mhzkb/submission/README.md

# Submission

submission
