mhzkb/submission/case/bottom-mount-case.FCStd

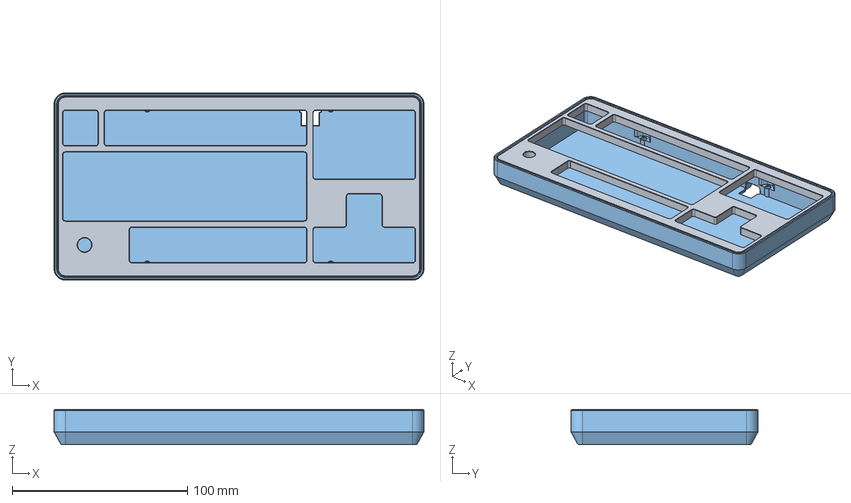
[picture p1: CAD file, 2025-06-23]
case/bottom-mount-case.FCStd
211.1 x 106.8 x 20.0 mm
top_case
SUBM
