mhzkb/submission/pcb/export/submission.step

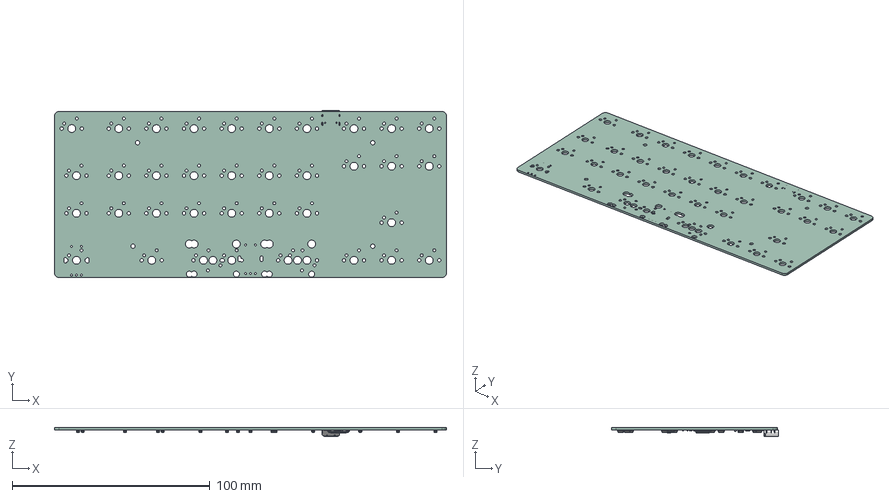
[picture p2: CAD file, 2025-10-24]
pcb/export/submission.step
198.4 x 84.6 x 4.45 mm
D_SOD_123 x 36
C_0402_1005Metric x 9
LQFP_48_7x7mm_P05mm
SW_SPST_TL3342 x 2
SOT_143
SOT_23
R_0402_1005Metric x 4
Fuse_1206_3216Metric
CON_TYPE-C-31-M-12 v0
C_0603_1608Metric
submission_PCB
