mhzkb/submission/plate/export/submission-plate.step

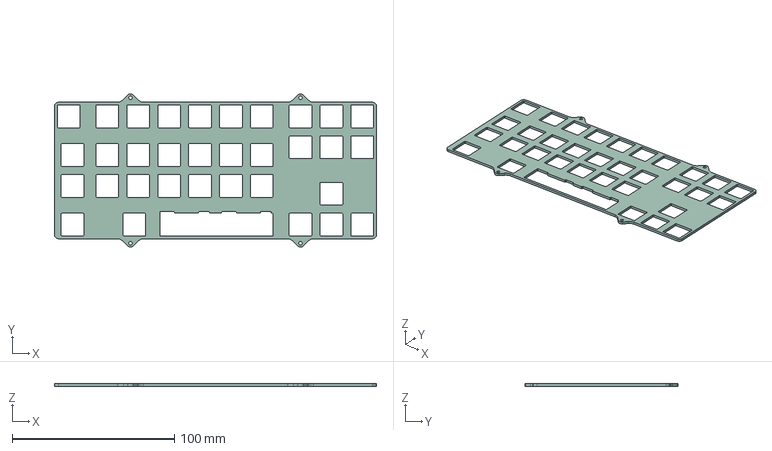
[picture p3: CAD file, 2026-05-04]
plate/export/submission-plate.step
198.4 x 94.5 x 1.60 mm
