mhzkb/submission/pcb/submission.kicad_pcb

## KiCad design pcb/submission.kicad_pcb (2026-05-04)

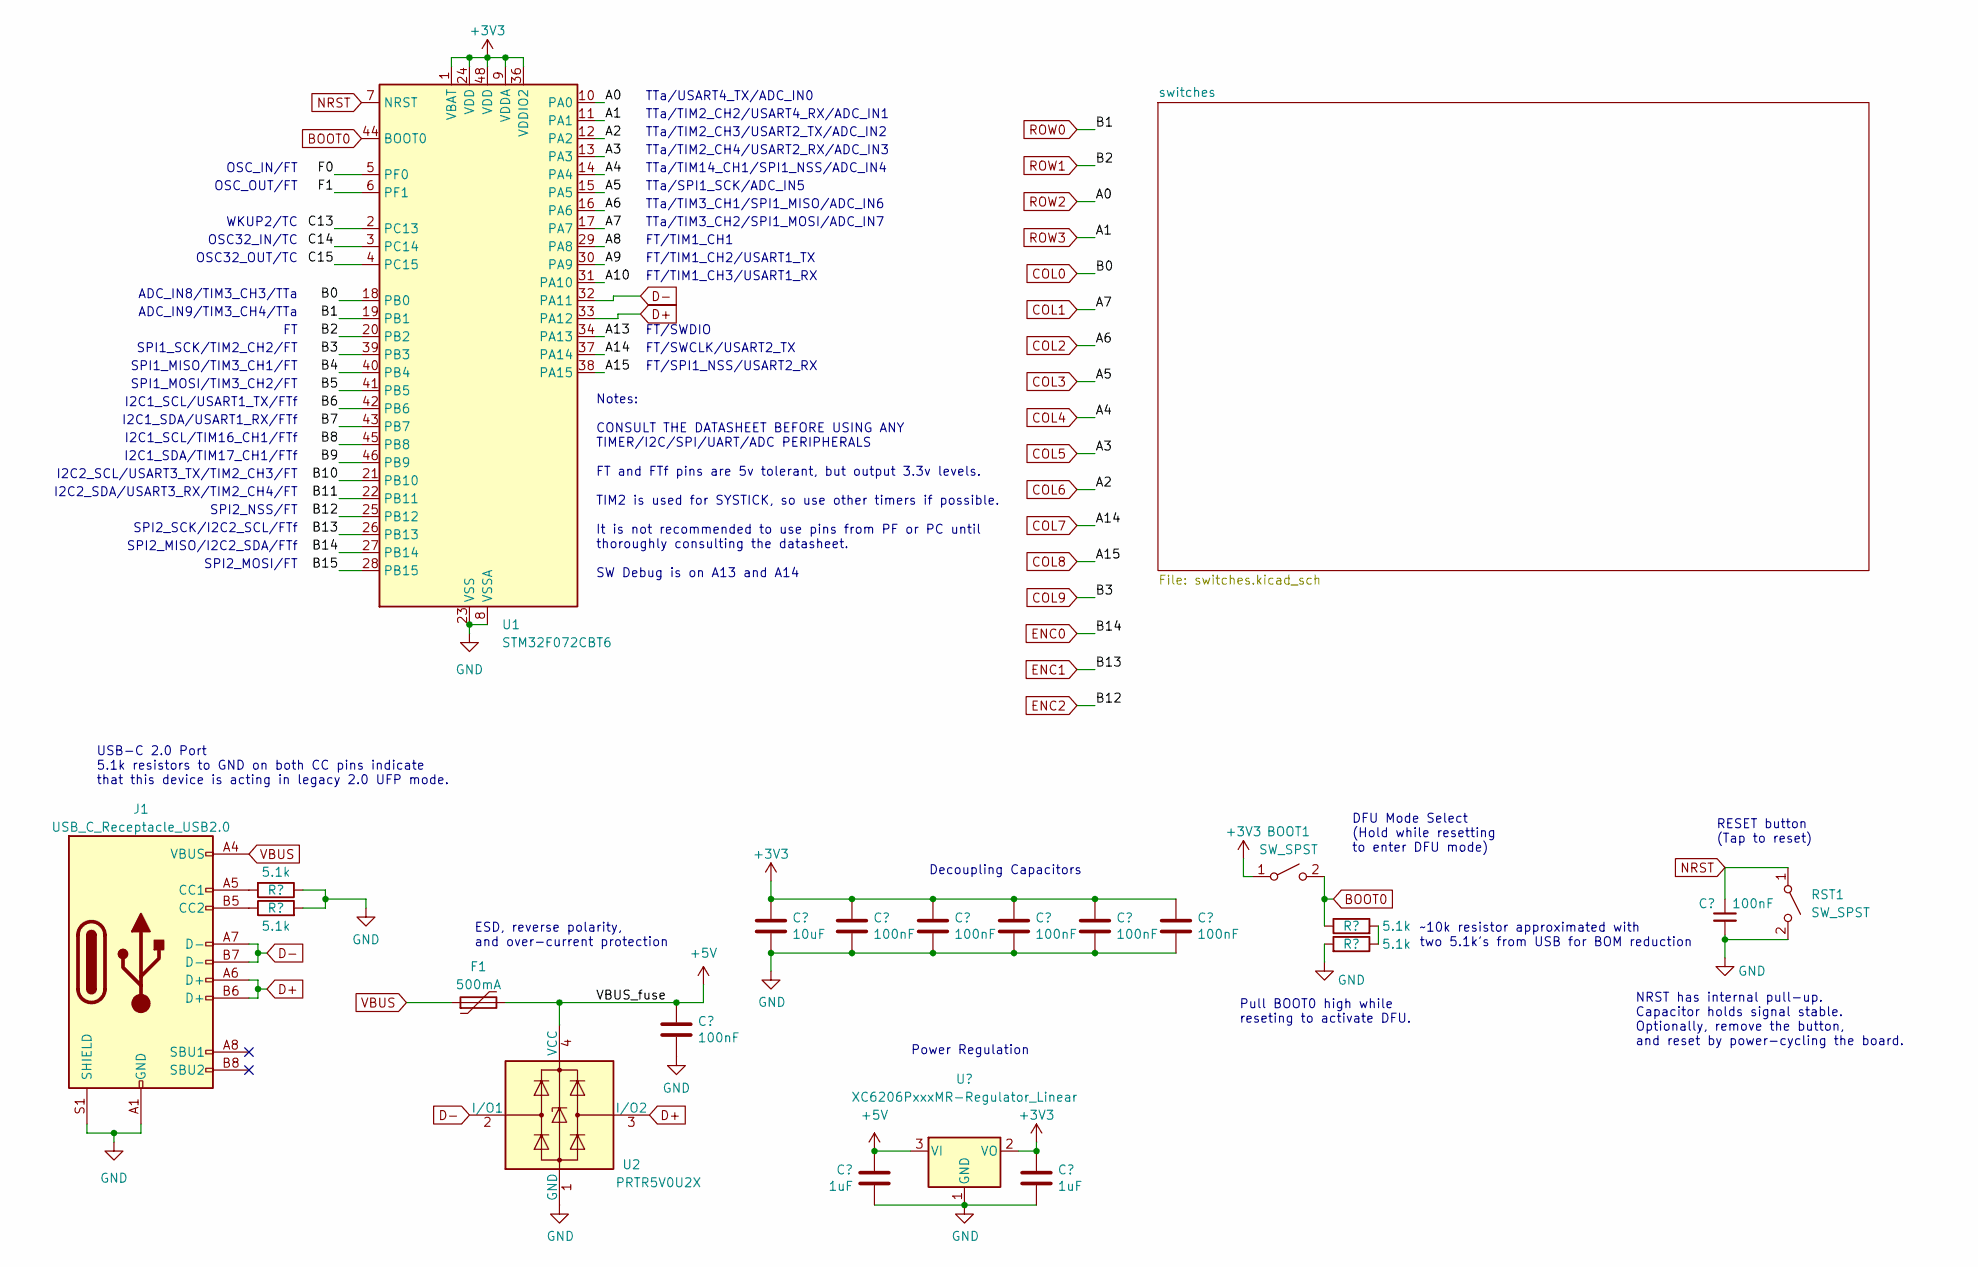
[picture p6: schematic submission.kicad_sch]

Parts:
BOOT1: SW_SPST; SW_SPST_TL3342
C1, C3, C4, C5, C6, C7, C8: 100nF; C_0402_1005Metric; LCSC C307331
C2: 10uF; C_0603_1608Metric; LCSC C307331
C9, C10: 1uF; C_0402_1005Metric; LCSC C307331
F1: 500mA; Fuse_1206_3216Metric; LCSC C135341
J1: USB_C_Receptacle_USB2.0; USB_C_Receptacle_HRO_TYPE-C-31-M-12; JlcRotOffset 180
R1, R2, R3, R4: 5.1k; R_0402_1005Metric
RST1: SW_SPST; SW_SPST_TL3342
U1: STM32F072CBT6; LQFP-48_7x7mm_P0.5mm; JlcRotOffset 90
U2: PRTR5V0U2X; SOT-143; LCSC C2827688
U3: XC6206PxxxMR-Regulator_Linear; SOT-23; LCSC C5446

Connections:
+3V3: BOOT1.1 (A), C2.1, C3.1, C4.1, C5.1, C6.1, C7.1, C10.1, U1.1 (VBAT), U1.9 (VDDA), U1.24 (VDD), U1.36 (VDDIO2), U1.48 (VDD), U3.2 (VO)
+5V: C8.1, C9.1, F1.2, U2.4 (VCC), U3.3 (VI)
/A8: U1.29 (PA8)
/A9: U1.30 (PA9)
/A10: U1.31 (PA10)
/A13: U1.34 (PA13)
/B4: U1.40 (PB4)
/B5: U1.41 (PB5)
/B6: U1.42 (PB6)
/B7: U1.43 (PB7)
/B8: U1.45 (PB8)
/B9: U1.46 (PB9)
/B10: U1.21 (PB10)
/B11: U1.22 (PB11)
/B15: U1.28 (PB15)
/C13: U1.2 (PC13)
/C14: U1.3 (PC14)
/C15: U1.4 (PC15)
/F0: U1.5 (PF0)
/F1: U1.6 (PF1)
BOOT0: BOOT1.2 (B), R3.1, U1.44 (BOOT0)
COL0: U1.18 (PB0); also elsewhere on the board
COL1: U1.17 (PA7); also elsewhere on the board
COL2: U1.16 (PA6); also elsewhere on the board
COL3: U1.15 (PA5); also elsewhere on the board
COL4: U1.14 (PA4); also elsewhere on the board
COL5: U1.13 (PA3); also elsewhere on the board
COL6: U1.12 (PA2); also elsewhere on the board
COL7: U1.37 (PA14); also elsewhere on the board
COL8: U1.38 (PA15); also elsewhere on the board
COL9: U1.39 (PB3); also elsewhere on the board
D+: J1.A6 (D+), J1.B6 (D+), U1.33 (PA12), U2.3 (I/O2)
D-: J1.A7 (D-), J1.B7 (D-), U1.32 (PA11), U2.2 (I/O1)
ENC0: U1.27 (PB14); also elsewhere on the board
ENC1: U1.26 (PB13); also elsewhere on the board
ENC2: U1.25 (PB12); also elsewhere on the board
GND: C1.2, C2.2, C3.2, C4.2, C5.2, C6.2, C7.2, C8.2, C9.2, C10.2, J1.A1 (GND), J1.A12 (GND), J1.B1 (GND), J1.B12 (GND), J1.S1 (SHIELD), R1.1, R2.2, R4.2, RST1.2 (B), U1.8 (VSSA), U1.23 (VSS), U1.35 (VSS), U1.47 (VSS), U2.1 (GND), U3.1 (GND); also elsewhere on the board
NRST: C1.1, RST1.1 (A), U1.7 (NRST)
unnamed: J1.A5 (CC1), R1.2
unnamed: J1.B5 (CC2), R2.1
unnamed: R3.2, R4.1
ROW0: U1.19 (PB1); also elsewhere on the board
ROW1: U1.20 (PB2); also elsewhere on the board
ROW2: U1.10 (PA0); also elsewhere on the board
ROW3: U1.11 (PA1); also elsewhere on the board
VBUS: F1.1, J1.A4 (VBUS), J1.A9 (VBUS), J1.B4 (VBUS), J1.B9 (VBUS)

Notes on the sheet:
SPI1_SCK/TIM2_CH2/FT
FT/TIM1_CH1
FT/TIM1_CH3/USART1_RX
SPI2_NSS/FT
Notes: CONSULT THE DATASHEET BEFORE USING ANY TIMER/I2C/SPI/UART/ADC PERIPHERALS FT and FTf pins are 5v tolerant, but output 3.3v levels. TIM2 is used for SYSTICK, so use other timers if possible. It is not recommended to use pins from PF or PC until thoroughly consulting the datasheet. SW Debug is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
TTa/TIM2_CH4/USART2_RX/ADC_IN3
NRST has internal pull-up. Capacitor holds signal stable. Optionally, remove the button, and reset by power-cycling the board.
FT/SWDIO
Decoupling Capacitors
SPI1_MOSI/TIM3_CH2/FT
ADC_IN9/TIM3_CH4/TTa
I2C2_SCL/USART3_TX/TIM2_CH3/FT
SPI2_MISO/I2C2_SDA/FTf
FT/SWCLK/USART2_TX
I2C1_SCL/TIM16_CH1/FTf
~10k resistor approximated with two 5.1k's from USB for BOM reduction
TTa/TIM2_CH2/USART4_RX/ADC_IN1
USB-C 2.0 Port 5.1k resistors to GND on both CC pins indicate that this device is acting in legacy 2.0 UFP mode.
TTa/TIM2_CH3/USART2_TX/ADC_IN2
OSC_IN/FT
DFU Mode Select (Hold while resetting to enter DFU mode)
WKUP2/TC
I2C2_SDA/USART3_RX/TIM2_CH4/FT
ADC_IN8/TIM3_CH3/TTa
RESET button (Tap to reset)
Pull BOOT0 high while reseting to activate DFU.
I2C1_SDA/TIM17_CH1/FTf
TTa/SPI1_SCK/ADC_IN5
TTa/TIM3_CH1/SPI1_MISO/ADC_IN6
TTa/TIM3_CH2/SPI1_MOSI/ADC_IN7
OSC32_OUT/TC
FT/SPI1_NSS/USART2_RX
SPI1_MISO/TIM3_CH1/FT
OSC32_IN/TC
TTa/TIM14_CH1/SPI1_NSS/ADC_IN4
I2C1_SDA/USART1_RX/FTf
SPI2_MOSI/FT
FT/TIM1_CH2/USART1_TX
Power Regulation
SPI2_SCK/I2C2_SCL/FTf
OSC_OUT/FT
ESD, reverse polarity, and over-current protection
TTa/USART4_TX/ADC_IN0
I2C1_SCL/USART1_TX/FTf

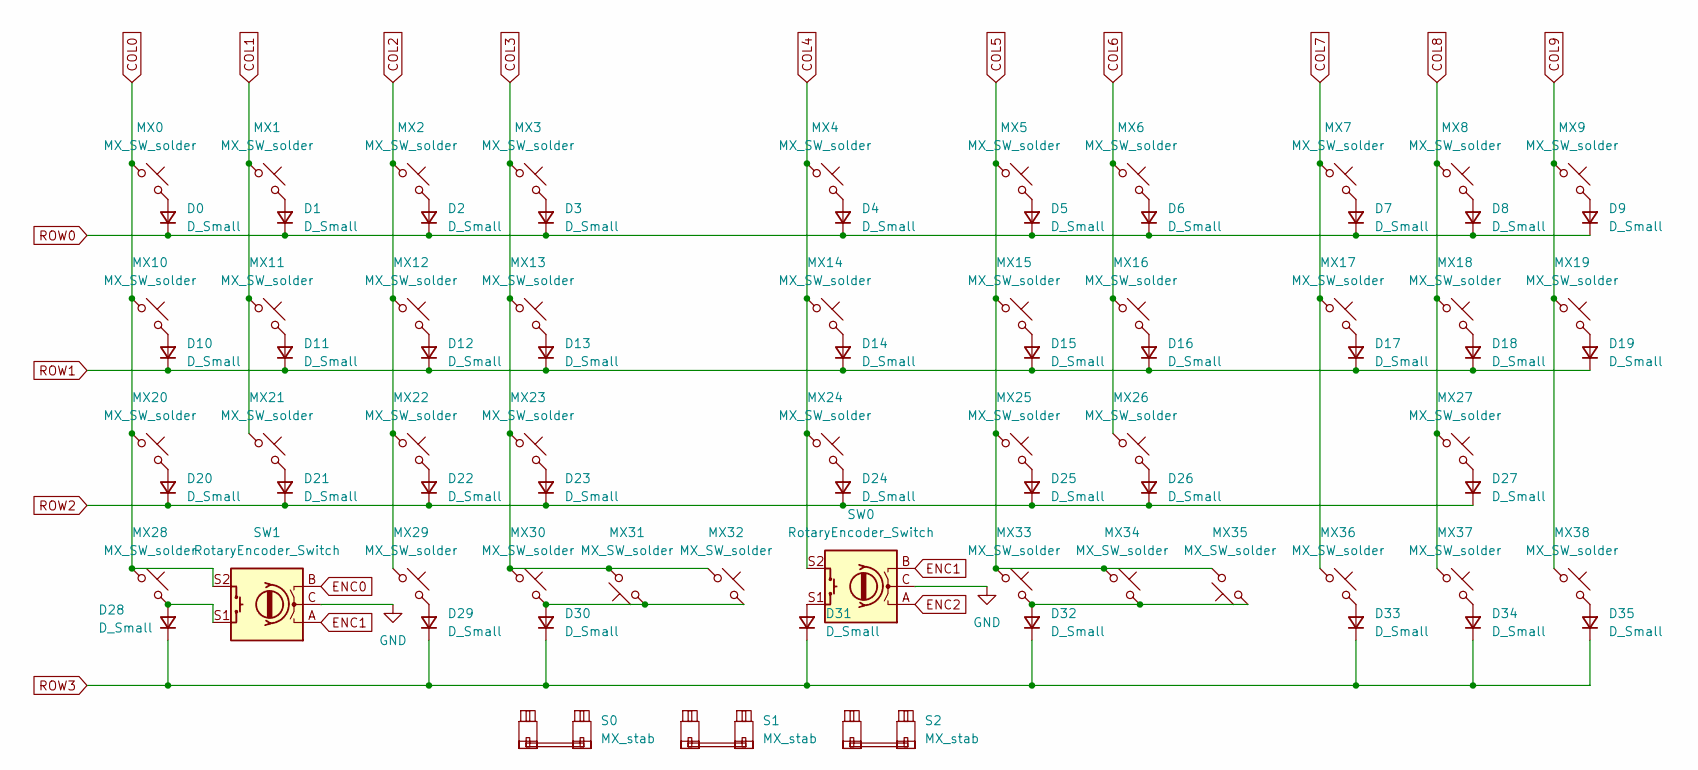
[picture p7: schematic switches.kicad_sch]

Parts:
D0, D1, D2, D3, D4, D5, D6, D7, D8, D9, D10, D11, D12, D13, D14, D15, D16, D17, D18, D19, D20, D21, D22, D23, D24, D25, D26, D27, D28, D29, D30, D31, D32, D33, D34, D35: D_Small; D_SOD-123
MX0, MX1, MX2, MX3, MX4, MX5, MX6, MX7, MX8, MX9, MX11, MX12, MX13, MX14, MX15, MX16, MX17, MX18, MX19, MX21, MX22, MX23, MX24, MX25, MX26, MX27, MX31, MX32, MX34, MX35, MX36, MX37, MX38: MX_SW_solder; SW_MX_1u
MX10, MX20, MX28, MX29: MX_SW_solder; SW_MX_1.25u
MX30, MX33: MX_SW_solder; SW_MX_1.5u
S0: MX_stab; STAB_MX_P_3u
S1, S2: MX_stab; STAB_MX_P_2u
SW0, SW1: RotaryEncoder_Switch; RotaryEncoder_EC11

Connections:
COL0: MX0.1, MX10.1, MX20.1, MX28.1, SW1.S2; also elsewhere on the board
COL1: MX1.1, MX11.1, MX21.1; also elsewhere on the board
COL2: MX2.1, MX12.1, MX22.1, MX29.1; also elsewhere on the board
COL3: MX3.1, MX13.1, MX23.1, MX30.1, MX31.2, MX32.1; also elsewhere on the board
COL4: MX4.1, MX14.1, MX24.1, SW0.S2; also elsewhere on the board
COL5: MX5.1, MX15.1, MX25.1, MX33.1, MX34.1, MX35.2; also elsewhere on the board
COL6: MX6.1, MX16.1, MX26.1; also elsewhere on the board
COL7: MX7.1, MX17.1, MX36.1; also elsewhere on the board
COL8: MX8.1, MX18.1, MX27.1, MX37.1; also elsewhere on the board
COL9: MX9.1, MX19.1, MX38.1; also elsewhere on the board
ENC0: SW1.B; also elsewhere on the board
ENC1: SW0.B, SW1.A; also elsewhere on the board
ENC2: SW0.A; also elsewhere on the board
GND: SW0.C, SW1.C; also elsewhere on the board
unnamed: D0.2 (A), MX0.2
unnamed: D1.2 (A), MX1.2
unnamed: D2.2 (A), MX2.2
unnamed: D3.2 (A), MX3.2
unnamed: D4.2 (A), MX4.2
unnamed: D5.2 (A), MX5.2
unnamed: D6.2 (A), MX6.2
unnamed: D7.2 (A), MX7.2
unnamed: D8.2 (A), MX8.2
unnamed: D9.2 (A), MX9.2
unnamed: D10.2 (A), MX10.2
unnamed: D11.2 (A), MX11.2
unnamed: D12.2 (A), MX12.2
unnamed: D13.2 (A), MX13.2
unnamed: D14.2 (A), MX14.2
unnamed: D15.2 (A), MX15.2
unnamed: D16.2 (A), MX16.2
unnamed: D17.2 (A), MX17.2
unnamed: D18.2 (A), MX18.2
unnamed: D19.2 (A), MX19.2
unnamed: D20.2 (A), MX20.2
unnamed: D21.2 (A), MX21.2
unnamed: D22.2 (A), MX22.2
unnamed: D23.2 (A), MX23.2
unnamed: D24.2 (A), MX24.2
unnamed: D25.2 (A), MX25.2
unnamed: D26.2 (A), MX26.2
unnamed: D27.2 (A), MX27.2
unnamed: D28.2 (A), MX28.2, SW1.S1
unnamed: D29.2 (A), MX29.2
unnamed: D30.2 (A), MX30.2, MX31.1, MX32.2
unnamed: D31.2 (A), SW0.S1
unnamed: D32.2 (A), MX33.2, MX34.2, MX35.1
unnamed: D33.2 (A), MX36.2
unnamed: D34.2 (A), MX37.2
unnamed: D35.2 (A), MX38.2
ROW0: D0.1 (K), D1.1 (K), D2.1 (K), D3.1 (K), D4.1 (K), D5.1 (K), D6.1 (K), D7.1 (K), D8.1 (K), D9.1 (K); also elsewhere on the board
ROW1: D10.1 (K), D11.1 (K), D12.1 (K), D13.1 (K), D14.1 (K), D15.1 (K), D16.1 (K), D17.1 (K), D18.1 (K), D19.1 (K); also elsewhere on the board
ROW2: D20.1 (K), D21.1 (K), D22.1 (K), D23.1 (K), D24.1 (K), D25.1 (K), D26.1 (K), D27.1 (K); also elsewhere on the board
ROW3: D28.1 (K), D29.1 (K), D30.1 (K), D31.1 (K), D32.1 (K), D33.1 (K), D34.1 (K), D35.1 (K); also elsewhere on the board

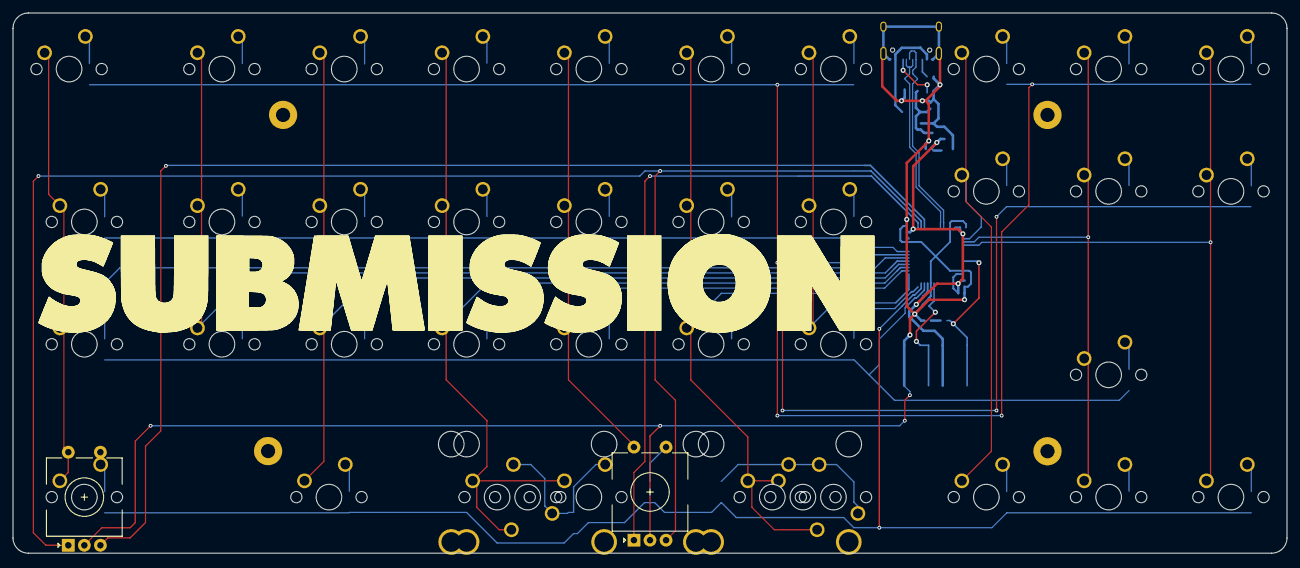
[picture p8: board submission.kicad_pcb from above]

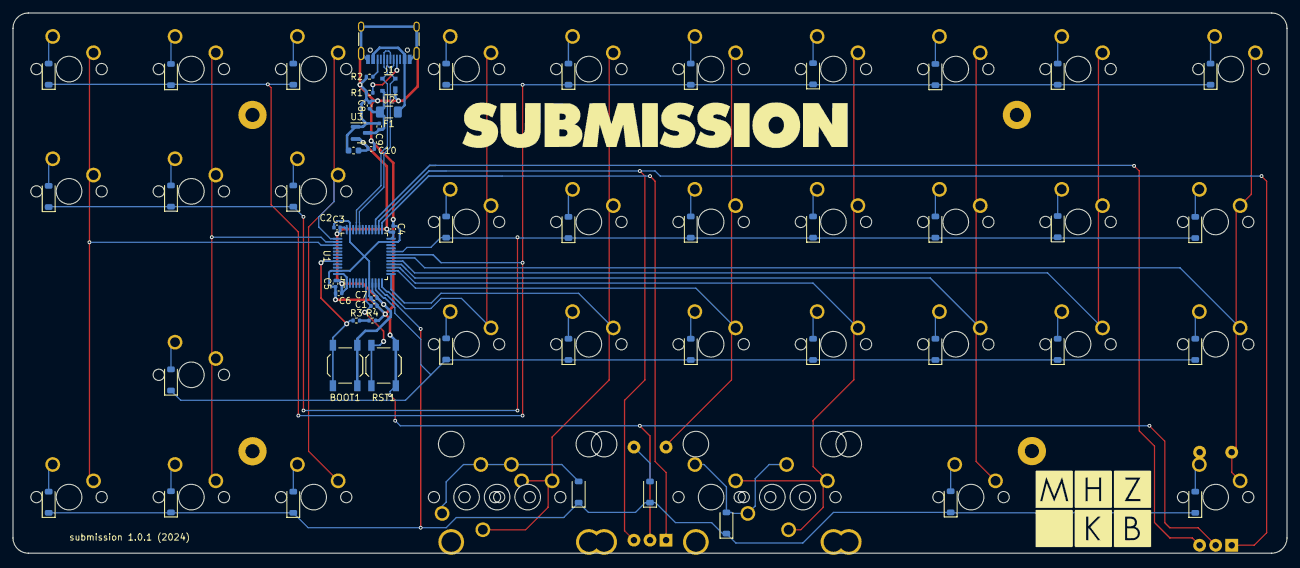
[picture p9: board submission.kicad_pcb from below]

Board: 2 copper layers, 198.4 x 84.1 mm, 101 parts (57 on the bottom side), 64 nets.
