mhzkb/submission/(commit log)

2025-06-15 Added case source file.
    [bottom-mount-case.FCStd]
2025-06-21 Converted case to single size (6x3 mm) magnets.
    [bottom-mount-case.FCStd]
2025-06-23 Added alternative bottom styles.
    [bottom-mount-case.FCStd]
2025-10-24 Added Kicad project and export files
    [bom.csv, positions.csv, submission.kicad_pcb, submission.kicad_sch, submission.step]
2026-05-04 Updated pcb silkscreen
    [submission.kicad_pcb]
2026-05-04 Added missing matrix schematic
    [switches.kicad_sch]
2026-05-04 Added submission plate files
    [submission-plate.kicad_pcb, submission-plate.kicad_sch, submission-plate.step]
